ZoeGet/Omi/Tools/CodexMonitor/README.md

# Codex 状态采集实验 / Codex lifecycle monitor

Windows 主机端工具，读取 Codex Hook 的生命周期 JSON，按会话、轮次和工具调用 ID 保存状态。源码采集器只使用 Python 标准库，开发运行需 Python 3.10+；Windows 便携包已内置运行环境，终端用户无需安装 Python。

本目录负责状态来源，不实现设备传输、灯带驱动或桌面气泡；相关设备功能见根目录 README。已有快照不能当作持续在线的证明。以下带日期的实验记录保留各次验证边界，后续结果以最新现状及 Git 历史为准。

## 文件 / Files

| 文件 | 职责 |
| --- | --- |
| `collector.py` | UTF-8 输入、Windows 互斥锁、审批关联及原子快照写入 |
| `make_hooks.py` | 只向标准输出生成配置，不修改用户设置 |
| `audit.py` | 只读诊断与按会话、轮次检查 |
| `state_view.py` | CLI 只读视图及桌面实际使用的 `LifecycleReader`，不作为 Hook 入口 |
| `process_probe.py` | 只读核对 Windows 进程身份及退出信号，不推断会话状态 |
| `host_observer.py` | 从 Hook 进程的父进程链采集独立宿主证据 |
| `host_sample_collector.py` | 临时采样包装器，先执行原生命周期采集再隔离记录证据 |
| `host_bindings.py` | 按同会话/轮次/调用的 Pre/Post 配对生成候选绑定 |
| `bound_collector.py`、`host_binding_sidecar.py` | 共享事件关联与原子发布；桌面 `hook_runner.py` 通过 `run` 复用，关联失败不阻断生命周期采集 |
| `tests/test_approvals.py` | 隔离目录内的生命周期、隐私及多进程回归 |
| `tests/test_input_requests.py`、`test_lifecycle_reader.py` | 同步/异步输入、同聊天运行与跨聊天优先级、桌面生命周期延续及失效 |
| `tests/test_audit.py` | 缺失来源、目标隔离、损坏行及审批覆盖率测试 |
| `tests/test_state_view.py` | 静默、过期、损坏、时钟异常及只读性测试 |
| `tests/test_process_probe.py` | 进程身份、PID 重用、访问失败及真实隔离子进程测试 |
| `tests/test_host_observer.py` | 父进程链、采样隐私、失败隔离及绑定冲突测试 |
| `tests/test_host_binding_sidecar.py`、`test_bound_collector.py` | 事件精确匹配、迟到事件、宿主变更及真实父进程/原采集器回归 |

## 安装 / Setup

普通 Windows 用户使用完整 Omi 发布包中的首次监控向导，见 [快速开始](../Desktop/QUICK_START.md)。下面的 Python 手动安装流程保留供开发者调试和历史部署维护。桌面包使用内置运行环境执行同一生命周期/绑定逻辑，安装后的就绪检测必须等待真实新事件；不会自动授予 Hook 信任。

1. 备份已有 `~/.codex/hooks.json`，以及已有的 `~/.codex/hooks/omipet-monitor/collector.py`。保留旧状态目录作为回退证据。
2. 将本目录的 `collector.py` 复制到 `~/.codex/hooks/omipet-monitor/collector.py`。
3. 在仓库根目录运行以下命令，生成与当前解释器、安装路径对应的配置预览：

```powershell
$monitorCollectorPath = Join-Path $env:USERPROFILE '.codex/hooks/omipet-monitor/collector.py'
python Tools/CodexMonitor/make_hooks.py --collector $monitorCollectorPath
```

生成的配置包含 8 个事件。将这些处理器合并到用户级 `hooks.json`；已安装本工具时更新对应处理器，避免重复注册。保留其他工具的 Hook，不覆盖整份现有配置。处理器使用绝对解释器和脚本路径；更换 Python 或移动脚本后需要重新生成。

4. 在 Codex 中审查并信任新定义。官方 CLI 入口为 `/hooks`；安装配置不代表已经受信任。不自动修改信任记录或使用信任绕过参数。
5. 在正常聊天中验证新事件。审批只观察用户自行处理的请求，不自动批准、拒绝或制造危险操作。

上述手动步骤仅安装基础采集器，不自动建立桌面监控所需的 schema 2 宿主关联。普通用户应使用完整向导安装；开发者手动包装需同时配置下文事件关联侧文件，不能把单独的 `collector.py` 快照当作桌面就绪。

默认 `SessionStart`、`Stop`、`SessionEnd` 同步执行，其他事件异步执行；超时为 3 秒。异步事件可能乱序，不能将接收顺序当成操作发生顺序。另见 [官方 Hooks 文档](https://learn.chatgpt.com/docs/hooks)。

## 本地数据与隐私 / Local data and privacy

默认目录：`%LOCALAPPDATA%/OmiPet/codex-monitor-probe-v2`。可用进程环境变量 `OMIPET_CODEX_MONITOR_DIR` 改到隔离目录，测试使用此方法，不写真实状态。

- `events.jsonl`：收到的生命周期元数据及处理结果。
- `sessions/*.json`：各会话的轮次和工具关联状态。
- `snapshot.json`：已观测会话的汇总。
- `collector-error-<PID>.json`：失败时间和异常类型，不写原始输入或异常中的敏感内容。

只保存会话/轮次/工具 ID、事件、工作目录、权限模式和派生状态。不保存提示词、工具入参、回复、凭证或命令指纹。工作目录和 ID 本身仍是本地元数据，不应将这些日志、快照、配置备份或个人安装收据提交到 Git。

采集器退出时不向标准输出返回决策；采集失败也不会代替用户审批。

## 状态与边界 / States and limits

| 状态 | 含义 |
| --- | --- |
| `working` | 当前用户任务正在执行，且没有优先显示的同步输入或真实审批 |
| `waitingApproval` | 存在真实审批/同步输入，或当前任务已停止而仍有本任务的异步待回复问题 |
| `idle` | 当前用户任务结束/中断，且没有仍参与显示判定的运行或等待项 |
| `offline` | 收到 `SessionEnd` |
| `unknown` | 来源不足、关联不明或缺失必要标识 |

`PermissionRequest` 提供调用 ID 时，只允许同一轮次、同一调用的 `PostToolUse` 清除对应项。普通工具的开始、其他工具的完成、旧轮次的结束均不会清除它。

本机实测发现，`request_permissions` 工具的窗口可以进入 Desktop 的 `waitingOnApproval`，却不触发 `PermissionRequest` Hook。因此还将这个工具的 `PreToolUse` 作为审批开始，通过相同调用 ID 的 `PostToolUse` 解除。

通用 `PermissionRequest` 不保证提供调用 ID。缺失时，后续工具活动不能证明是哪一项审批结束，状态会降级为 `unknown`/`approvalUnconfirmed`，直到本轮结束。`PostToolUse` 只证明调用已返回，不能单独推断用户批准还是拒绝。

按轮次保留已结束记录，可阻止迟到事件复活旧任务。`foregroundTurnId` 跟踪当前用户提交的任务；新提交接替旧任务，迟到的旧工具事件/Stop 不会抢回前台。旧未结束轮次不再永久占用运行状态，背景异步问题保留 pending 记录但不阻止新任务完成；真正未完成的权限审批、同步输入和无标识事件仍保守处理。记录尚未自动裁剪。汇总只覆盖已观测会话，不能代表 Desktop 所有聊天。原始采集器不靠定时器制造业务事件；长时间没有新事件不能证明空闲或仍在线。桌面实际通过下文 `LifecycleReader` 校验宿主存活并延续已确认生命周期，但不提供独立逐聊天存活证明。

## 只读视图与桌面生命周期 / Read-only views and desktop lifecycle

`state_view.py` 不改写日志或快照，不修改安装与信任配置。它将历史观测和候选显示状态分开：

| 输出 | 含义 |
| --- | --- |
| `lastObservedStatus` | 快照中的最后观测，过期后仍保留 |
| `observationAgeSeconds` | 当前时间与该会话观测时间之差 |
| `displayStatus` / `reason` | 候选显示状态及其依据 |
| `sourceState=readable` | 文件可读，不代表 Codex 或采集器在线 |
| `liveness=unverified` | 当前没有持续存活证据 |

CLI 默认未设置新鲜度策略，各会话显示 `unknown`，不会将历史红/黄/绿作为当前状态。调用方可显式传入正数 `--max-age-seconds`；测试中的 10 秒仅为合成边界测试。`read_bound_view` 保持该保守行为。桌面专用 `LifecycleReader` 只在近期、精确事件证明且宿主存活时接纳生命周期；后续没有新 Hook 仍保持工作/等待，独立评估传输有效期，不改写事件时间。来源不可读、身份/证明变化或宿主失效会清除接纳记录，重开监控不会接纳过期历史。它不证明具体聊天存活；当前任务漏掉 Stop 且没有新的用户任务接替时仍可能保留旧状态；新的用户任务会接替旧任务，自己的 Stop 可正常结束。

2026-10-16 一致性修复：`bound_collector.py` 在原有同目录互斥锁内完成生命周期与侧文件发布，桌面读取同样持有这把锁，避免新快照配上旧证明而短暂降级。锁的原有 1 秒等待上限不变；无法取得锁时仍显示 unknown 并清除延续资格，不沿用未核验状态。桌面后台和已安装包装器需配套更新；只升级其中一个不能保证一致性。并发回归已先复现旧实现读到半次发布，再验证新实现等待完整发布后读到结束状态；此前 30 分钟的 3 次 unknown 缺少逐次原因，不能全部归因于这一竞态。

`request_user_input` 的 Pre/Post 对应等待/回复完成；`request_user_input_async` 的 Post 只表示窗口已创建，等待需保留到 `UserPromptSubmit` 中对应 `send_user_message_question_reply` / `questionItemId` 回复，或中断/会话结束。待回复跨 Stop 保留，防止创建选项后结束本轮便错误变绿；其他工具调用与无关联文本不清除它。同一聊天继续执行时显示 working，当前任务停止且仍有本任务的异步问题时显示 waitingApproval；新用户任务接替后，旧问题只保留为背景记录，不自动标记已回答，也不覆盖新任务的完成状态；真实权限审批和同步输入仍优先显示 waitingApproval。不同聊天之间仍保持等待优先。自由输入选项使用同一回复关联，不保存问题、选项或回答文本。该应用回复格式来自本机实测，非通用 Hooks 稳定协议；格式改变需重新验证。[官方 Hooks 文档](https://learn.chatgpt.com/docs/hooks) 的工具返回事件不能等同异步人工回复。

每个会话分别计算年龄，不使用全局快照生成时间刷新其他聊天。超期、未来时间、缺少时区或非法记录均显示未知；静默不会产生 `Stop`、`idle` 或 `offline`。汇总保留等待审批、工作、未知、空闲、离线的优先级，未知会阻止仅凭另一个空闲会话显示全局空闲。

```powershell
python Tools/CodexMonitor/state_view.py
python Tools/CodexMonitor/state_view.py --source-unavailable
python Tools/CodexMonitor/tests/test_state_view.py
```

`--source-unavailable` 由调用方在已有独立失联证据时传入；该工具不探测或终止进程。来源缺失或损坏时同样返回未知，并给出来源原因；不尝试修复真实数据。

2026-10-14：状态视图 16 项、进程探针 10 项、宿主观测/绑定 16 项和审计 5 项测试通过，其中包括 Windows 隔离子进程真实退出及联动降级。开启宿主采样后的包装器还通过 52 条生命周期事件和 6 会话并发回归，最长单次约 0.281 秒。视图尚未接串口或灯带；不能宣称真实 Codex 会话异常退出已被自动识别。

## 进程证据 / Process evidence

`process_probe.py` 通过 Windows 的查询和同步权限读取进程，不读取命令行、环境变量、内存或登录资料，不终止被观察进程。身份由 PID、原始 100 ns 创建时间字符串和完整映像路径共同组成；创建时间使用字符串以免 JSON 数值精度损失。

核对使用同一个进程句柄读取创建时间与映像，并零等待检查退出信号。PID 重用、映像变化和访问失败均不能刷新原来源。进程退出或无法确认时显示未知；进程存活只表示主机进程存在，不证明聊天正在工作、Hook 正常或 UI 有响应。实现依据见 Microsoft 的 [GetProcessTimes](https://learn.microsoft.com/en-us/windows/win32/api/processthreadsapi/nf-processthreadsapi-getprocesstimes)、[QueryFullProcessImageNameW](https://learn.microsoft.com/en-us/windows/win32/api/winbase/nf-winbase-queryfullprocessimagenamew) 与 [WaitForSingleObject](https://learn.microsoft.com/en-us/windows/win32/api/synchapi/nf-synchapi-waitforsingleobject)。

入口：`process_probe.py --capture-pid <明确选择的PID>` 仅打印身份；`process_probe.py --identity <身份文件>` 重新查询该身份。生成的身份文件包含个人程序路径，不提交 Git。工具不按进程名自动选择宿主。

状态视图支持 `--process-bindings <绑定文件>`，格式如下，所有值均需由实测填写，不能照抄示例：

```json
{
  "schema": 1,
  "sessions": {
    "<已验证的session-id>": {
      "pid": 123,
      "creationTime100ns": "<capture返回的精确字符串>",
      "imagePath": "<capture返回的完整路径>"
    }
  }
}
```

每次读取视图都会重新查询对应进程，不信任旧的探针结果文件。缺失或非法绑定会降级未知；绑定进程运行也不能绕过缺省策略、观测过期或独立失联证据。这是附加的失效检查，不会把历史观测升级成实时状态，也不改写 Hook 日志。

## 真实 Hook 宿主采样 / Live Hook launcher sampling

`host_sample_collector.py` 是独立实验包装器。它优先加载同目录保存的 `lifecycle_collector.py`，仓库内运行时回退到原 `collector.py`；先完成原有采集，再读取同目录的 `host-observer.json`。未放置配置时不采样；采样配置/查询失败也不改变生命周期结果或标准输出。配置需明确给出 `enabled`、程序完整路径列表 `allowedImages` 和独立的绝对 `outputDirectory`。

父进程链通过只读 Windows Toolhelp 快照获得，再逐个核对创建时间、完整映像路径和存活状态。父进程比子进程新、链循环或查询期间身份变化时拒绝关联；只接受路径列表中最近的祖先进程。这里只证明 Hook 的启动来源，不代表进程独占会话或会话仍在运行。实现依据见 [PROCESSENTRY32W](https://learn.microsoft.com/en-us/windows/win32/api/tlhelp32/ns-tlhelp32-processentry32w) 和 [CreateToolhelp32Snapshot](https://learn.microsoft.com/en-us/windows/win32/api/tlhelp32/nf-tlhelp32-createtoolhelp32snapshot)。

每条样本使用独立随机文件名，只保存会话/轮次/调用 ID、事件、时间与祖先进程的 PID/创建时间/路径。样本可能包含个人目录，须保存在本地，不提交 Git。旧 `events.jsonl` 和快照格式不增加字段。

2026-10-14 19:27–19:28 的短暂真实采样得到 2 个会话、9 条 Pre/Post 事件；9 条均为 `Python → PowerShell → 同一个 codex.exe`。原采集器随后按 SHA-256 恢复，Hook 定义及信任记录未改，未安装持续后台任务。不同会话共享同一宿主，不能将进程当作聊天的独立心跳。第二个同名进程未因名称相同而被绑定。

`host_bindings.py --observations <样本目录>` 只向标准输出生成候选。每个会话须有同轮次、同调用 ID 的 Pre/Post 配对，且该批样本中的宿主身份一致；重复开始、其他调用/轮次的完成、未知或冲突宿主均不能满足绑定。损坏的输入使整个输入失效。输出保留配对证据数，`sessionLiveness` 始终未验证。

该批真实样本生成 2 个候选绑定，分别含 1 和 2 组工具配对。只读接入状态视图时两个宿主查询均为 running；没有观测有效期策略，汇总仍是 unknown。候选未启用持续采样，绑定只覆盖已观测的启动来源，不能外推到所有历史聊天或重启后的新来源。

## 持续事件绑定 / Event-correlated bindings

当前桌面安装使用版本化目录中的 `omi-device.exe --collect-hook`，由 `hook_runner.py` 调用 `bound_collector.run`；配置允许的 Codex 程序路径，设备当前视图上限仍为 16 个会话。磁盘上的历史状态和宿主证明不占这个名额；旧配置中的正数 `maxSessions` 保留兼容校验，不再限制历史证明写入，实际设备上限由桌面协议协商执行。新版本安装会备份并更新自有 Hook 定义，信任由 Codex 用户完成。侧文件位于状态目录的 `host-bindings.json`，包装器在原有互斥锁内发布生命周期和证明；关联失败不阻断原采集结果。开发者的手动脚本部署仍可使用同目录 `lifecycle_collector.py` 和 `host-binding-config.json`，不要与桌面安装重复注册。

同一会话、轮次及工具调用的 `PreToolUse`/`PostToolUse` 必须来自同一个经查询的父进程身份，才会标记 confirmed；之后每次事件还需与刚写入的原始时间、事件、轮次、调用 ID 以及 `applied=true` 精确对应。身份变化须重新配对，`SessionEnd` 删除该绑定。视图每次读取重新检查进程身份与最新事件证明；未覆盖的历史会话、迟到事件、损坏证据和过期事件均显示 unknown。进程存在仍不证明聊天持续运行。

历史验证（2026-10-15）：52 条合成事件与 Windows 父进程回归通过，随后真实 Hook 形成 confirmed 绑定并用于 USB 只读复测。持续关联只能随新事件覆盖当前会话，不能补造历史聊天。当前升级/卸载使用桌面向导的安装记录和备份；不要用早期本机临时探针脚本覆盖新版入口。恢复后旧侧文件证明也不能直接当成新事件。

USB/Wi-Fi 共用消息协议及真实观测桥接见 [DeviceBridge](../DeviceBridge/README.md)。USB 实验固件于 2026-10-14 完成首次烧录验证；`bridge.py` 可在前台持续读取本工具的原有快照，将临时别名和最后观测状态发送到设备，停止时尝试释放。2026-10-15 验证采用周期 1 秒、超时 2 秒、重试 1 次并运行 60 秒；未设置业务有效期，设备显示强制 unknown。SDK SOF 计数缺陷已通过隔离副本修复并烧录；复测 60 秒获 56 个真实观测 ACK，零超时/重建，link_losses 首尾均为 2、未新增，确认退出释放。长期稳定仍待验证。没有修改 Hook 或安装后台服务；该轮未验证真实控灯、新鲜度挑战和 Wi-Fi 传输；这些现已由 DeviceBridge 与桌面集成，当前边界见对应文档。

## 复核 / Verification

在仓库根目录运行：

```powershell
python Tools/CodexMonitor/tests/test_approvals.py
python Tools/CodexMonitor/tests/test_audit.py
python -m unittest discover -s Tools/CodexMonitor/tests -p test_input_requests.py
python -m unittest discover -s Tools/CodexMonitor/tests -p test_lifecycle_reader.py
python Tools/CodexMonitor/audit.py
python Tools/CodexMonitor/audit.py --session <session-id> --turn <turn-id>
```

生命周期测试包含 52 条合成事件和 6 会话并发；测试报告写在输出注明的临时目录，不写源码目录。审计工具支持 `--root` 指定其他来源、`--output` 导出报告。按目标轮次检查 `turnStatus`，不要用另一个聊天的 `Stop` 或当前会话的新消息替代完成证据。

2026-10-14 的实测边界：中文回复结束可正确记录 `Stop`；一个修复后的 `request_permissions` 窗口在用户批准后完成 `waitingApproval → working → idle`，同一调用的待审批数从 1 变为 0。期间其他聊天活动未覆盖等待状态。此为有限样本，拒绝、所有审批来源、长期稳定性和失联处理未全部验证。

## Codex 更新后排查与本次修复 / Upgrade troubleshooting

2026-10-19 修复了两个独立问题，之后复现时应分开诊断：

- **来源异常**：本机 Codex 更新后，原先选定的带版本目录的 `codex.exe` 路径失效，采集器的 `allowedImages` 仍指向旧路径。重新选择当前实际运行的 Codex 程序、修复安装、信任新 Hook，再取得真实同调用 Pre/Post 配对后恢复 `ready`。这是本次路径变化的原因，不能把所有来源异常都归因于更新。
- **结束后一直红**：真实 `Stop` 已收到，目标轮次 `turnStatus=idle`，会话汇总却仍 `status=working`；历史漏结束事件的轮次一直参与汇总。修复在 `collector.py` 保存 `foregroundTurnId`，由新用户任务接替旧普通工作；迟到的旧工具/Stop 不夺回前台。背景异步问题保留 pending，不伪造回答，也不阻止新任务完成；本任务待回复问题、真实审批与同步阻塞仍按前文规则处理。旧状态缺少此字段时从原 `turnId` 迁移。

### 恢复顺序

1. 保留日志及安装记录。在 Omi 设置的监控入口重新检测，核对当前实际运行的 Codex 程序；不要固定某个版本目录，也不要仅因同名进程就放宽路径校验。
2. 若路径变化，断开设备，重新选择当前 Codex 程序，点击“修复 / 更新监控”。若同时升级了采集逻辑，先更新完整 Omi 发布包，再通过此入口更新已安装组件：只换仓库源码、ZIP 或 Omi.exe 不会替换独立安装的旧采集器。覆盖发布目录前从托盘真正退出 Omi。
3. 安装器备份并合并自有 Hook，保留其他工具配置。在 Codex 审查并信任新定义；若新定义尚未加载，重新加载配置或重启 Codex 后再审查。不要自动修改信任记录，不要把重复点击安装当成收到事件的替代品。
4. 让 Codex 执行普通工具操作，再重新检测。确认 `hook-receipt.json` 的 `installationId` 与当前安装收据一致，宿主同一会话/轮次/调用的 Pre/Post 关联确认，设置显示 `ready`。单有采集事件或进程存在不够。
5. 开启设备监控，执行约 30 秒操作，结束后观察；再发送一个异步选项，暂不回答，观察黄灯，回答后观察恢复。默认颜色应为运行红、结束绿、待回复黄；自定义灯效按对应状态验收。真实权限审批另测，不为测试制造危险操作。

### 需要保留的证据

- `%LOCALAPPDATA%/OmiPet/monitor-setup.json`：当前安装 ID、所选 Codex 路径、运行目录及文件哈希；`monitor-backups/` 保存安装前配置。
- 状态目录中的 `hook-receipt.json`、`host-bindings.json`、`events.jsonl`、`sessions/*.json`：核对实际执行的版本、宿主关联和目标轮次事件。`CODEX_HOME` 或状态目录被显式改动时以实际配置为准。
- 结束仍红时，先区分“未收到目标 Stop”和“收到 Stop 但汇总错误”；对比 `turnStatus`、会话 `status`、`foregroundTurnId`、各轮次等待项。全会话 `pendingInputCount` 可含背景问题，非零不一定应亮黄灯。沿用上文 `audit.py --session ... --turn ...`，不要用其他轮次的 Stop 代替证据。
- 以上安装记录和日志含个人路径/标识，仅本地保留；不要提交 Git。不要删除快照、伪造 Stop 或放宽宿主校验来让灯变绿。

### 前台任务修复验证与边界

80 项监控单元测试、13 项输入/前台轮次专项测试、原有 9 组审批回归（52 合成事件/6 并发会话）、冻结采集器验证及 Windows 打包通过。2026-10-19 用户保持设备监控连接：30 秒真实操作期间为 `working`，用户确认结束恢复绿；异步选项未回答时确认黄，回答后再次确认正常。对应真实日志记录 `Stop → idle`、选项待回复 `Stop → waitingApproval`、回答后的 `Stop → idle`。本轮未重新实测真实权限审批、断线与长期运行；当前任务漏 Stop 且无新任务接替仍无法独立证明完成。Codex 若改变事件字段、异步回复格式或宿主结构，需要重新验证并按证据修复，不保证升级后永不适配。

原始事件、安装收据和备份仅在本地保留，以上内容为脱敏验证摘要。

### 历史聊天超过设备容量导致来源异常

2026-10-19 随后复现了另一个原因：历史快照累计 17 个聊天，而侧文件写入曾以整个历史快照长度检查 16 会话容量，导致所有当前宿主证明停止更新；设备映射也拒绝 17 条历史记录。此时安装版本和 Codex 路径均正确，重复修复安装无法消除根因。

修复将历史与当前视图分开：侧文件继续保存各聊天的真实证明；`LifecycleReader` 不把启动前已过原有 30 秒预算且未接纳的旧记录送往设备，已确认结束的聊天只保留最新一个作为空闲/离线显示。已接纳的运行/等待仍跨静默保留；本轮曾观察的未结束聊天即使证明失效，也继续显示未知，不因归档让另一个空闲聊天误报绿色。新事件可以重新激活历史聊天。原始日志、会话文件及完整快照不删除、不改写。只读审计接口仍展示全部历史，桌面视图用 `historicalSessionCount` 说明未参与当前显示的数量。

真实同时参与显示的会话仍受设备 16 会话上限约束，超限继续报告异常，不截断活动审批；设备临时别名累计耗尽仍按既有流程重新握手。回归覆盖 17 条历史、18 条宿主证明、长任务/等待、完成记录收拢、证明丢失与真实活动超限。本次修复必须同时更新 Omi 后台与已安装采集器，再信任新定义并验证真实事件；仅重装旧包无效。实机验收范围见本节末尾的验证摘要。

累计聊天和磁盘历史没有固定数量上限，也没有自动裁剪策略，实际仍受存储、内存和处理时间限制。16 是当前设备视图的协商上限，包含参与显示的未知条目和保留的最新结束记录，不能理解成“只能累计新建 16 个聊天”或“只计算正在运行的聊天”。历史增多不再触发旧的全局停写条件；当前视图确实超限仍失败关闭。“电脑仅发最终汇总状态”的方案尚未实现。

本次容量修复最终通过 83 项监控单元测试、32 项设备协议及 29 项桥接回归，冻结包的关联/状态/传输验证通过。新版后台和采集器已安装并由用户信任；真实现场保留 17 个历史聊天，30 秒 7 次检查均为 `working`，当前传输 1 个会话，16 条历史记录不占当前名额，用户随后确认灯色已恢复。本轮未重新实测真实权限审批、断线或长期稳定性，不能据短测承诺无限会话或长期无故障。

## 回退 / Rollback

恢复安装前保存的脚本和对应的 Hook 定义，核对之后是否追加了其他配置；定义变化后按 Codex 提示重新审查。保留原日志与快照，不把新旧采集器同时写到同一状态目录。停用时只禁用本工具对应的处理器。

2026-10-15 状态有效期候选已在 USB 桥接层加入显式参数和传输时间预留；默认仍显示 unknown。以前短时采样生成的 2 个宿主绑定本次复核均为 unknown，因此不能用于开启真实状态。在显式 30 秒实验预算下，短时采样取得 1 个当前会话绑定并恢复原采集器；仅显式实验启用，未接灯带，详见 DeviceBridge 文档。

2026-10-15 后续将 Hook 采集时间同时绑定到 Windows 单调时钟计数，侧文件增加十进制 `observedMonotonicNs`。schema 2 视图用它计算事件年龄；缺失、倒退或异常计数一律 unknown。桥接生成快照时再扣除单调时钟经过的时间，墙上时间跳变不能延长已观测状态。原 UTC 时间仍用于审计；宿主进程身份实时核对也阻止重启后的旧计数直接沿用。旧侧文件记录会因缺少单调证明降级，直到新 Hook 事件更新。当次用户级包装器按哈希升级，未更改当次 Hook 定义和原生命周期采集器；当前便携包升级使用版本化安装，定义变化需重新审查。
