ZoeGet/Omi/Hardware/Enclosure/Backcover.STEP

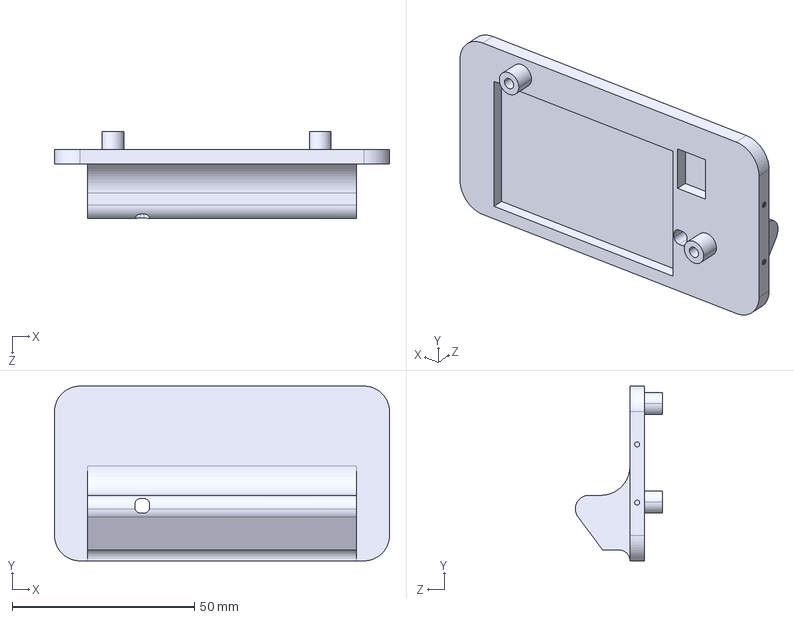
[picture p1: CAD file, 2026-10-14]
Hardware/Enclosure/Backcover.STEP
92.0 x 48.0 x 24.0 mm
