ZoeGet/Omi/Hardware/Enclosure/Frontcover.STEP

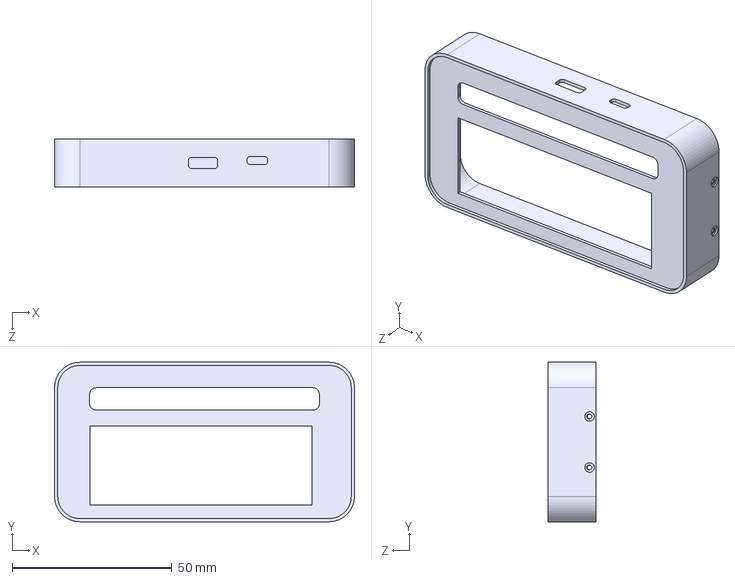
[picture p2: CAD file, 2026-10-14]
Hardware/Enclosure/Frontcover.STEP
94.0 x 50.0 x 15.0 mm
