ZoeGet/Omi/Firmware/include/omi_ui_font.h

#pragma once
#include <cstdint>

//  生成的 Omi UI 字模，源字体及许可见 assets/fonts / Generated Omi UI glyphs; source and license in assets/fonts
//  使用 generate_ui_font.py 重建，4 位覆盖率按行高半字节优先 / Rebuild with generate_ui_font.py; row-major 4-bit coverage, high nibble first
namespace OmiPetUiFont {
struct Glyph { uint32_t codepoint, offset; uint8_t size, width, height, advance; int8_t left, top; };
constexpr uint8_t kPixels[] = {
  0x04, 0x10, 0x0b, 0x40, 0x0a, 0x30, 0x0a, 0x30, 0x0a, 0x20, 0x09, 0x20, 0x04, 0x10, 0x05, 0x20, 0x0c, 0x50, 0x02, 0x02, 0x00, 0xf0, 0xd3, 0x0e,
  0x0c, 0x20, 0xb0, 0xa0, 0x00, 0x00, 0x00, 0x00, 0x00, 0x00, 0x00, 0x00, 0x00, 0x00, 0x00, 0x00, 0x00, 0x00, 0x90, 0x90, 0x02, 0x80, 0xa0, 0x3b,
  0xda, 0xd8, 0x05, 0x51, 0x90, 0x07, 0x32, 0x70, 0x6d, 0xbc, 0xc5, 0x0a, 0x06, 0x40, 0x0a, 0x08, 0x20, 0x00, 0x00, 0x00, 0x00, 0x47, 0x00, 0x02,
  0xbe, 0x90, 0x0c, 0x51, 0x70, 0x0e, 0x10, 0x00, 0x06, 0xd5, 0x00, 0x00, 0x2b, 0xa0, 0x00, 0x00, 0xc4, 0x15, 0x00, 0xd3, 0x19, 0xdd, 0x70, 0x00,
  0x47, 0x00, 0x00, 0x00, 0x00, 0x1b, 0xb6, 0x00, 0x55, 0x00, 0x56, 0x0b, 0x00, 0xa0, 0x00, 0x84, 0x0b, 0x17, 0x30, 0x00, 0x66, 0x0c, 0x19, 0x4b,
  0xa1, 0x1a, 0xa5, 0x82, 0xb1, 0x48, 0x00, 0x02, 0x80, 0xb0, 0x2a, 0x00, 0x09, 0x10, 0xa0, 0x48, 0x00, 0x46, 0x00, 0x4b, 0xb2, 0x01, 0xbb, 0x50,
  0x00, 0x07, 0x70, 0xc0, 0x00, 0x06, 0x87, 0x80, 0x00, 0x03, 0xf8, 0x00, 0x41, 0x2c, 0x9b, 0x02, 0xd0, 0x77, 0x08, 0xaa, 0x60, 0x7b, 0x00, 0xce,
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
  {65, 725, 11, 7, 8, 7, 0, -8},
  {66, 753, 11, 7, 8, 7, 0, -8},
  {67, 781, 11, 7, 8, 7, 0, -8},
  {68, 809, 11, 8, 8, 8, 0, -8},
  {69, 841, 11, 6, 8, 6, 0, -8},
  {70, 865, 11, 6, 8, 6, 0, -8},
  {71, 889, 11, 8, 8, 8, 0, -8},
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
};
}  //  字模命名空间 / Glyph namespace
