ZoeGet/Omi/(commit log)

2026-10-12 fix(led): prevent color corruption when switching brightness
    [led_controller.cpp, led_controller.h, main.cpp]
2026-10-12 Show battery percentage only on display
2026-10-14 Update front and back enclosure STEP models
    [Backcover.STEP, Frontcover.STEP]
2026-10-14 chore(enclosure): update back cover STEP model
    [Backcover.STEP]
2026-10-14 feat(monitor): add Codex lifecycle and approval collector
    Track per-session turns and correlate permission tools by call ID. Preserve uncertain approval states, ignore late events, and keep raw inputs out of local metadata.
    Include a read-only hook configuration generator and 52-event regression coverage with six concurrent sessions.
2026-10-14 docs(monitor): document setup and validated lifecycle behavior
    Describe hook installation, local metadata privacy, approval correlation, regression commands, and rollback. Record the limits of the observed approval sample and the remaining source-liveness work.
2026-10-15 chore(repo): define publication boundaries and staged checks
2026-10-15 feat(desktop): add Windows USB device control center
2026-10-15 fix(desktop): fit light summaries and stack mode switches
2026-10-16 docs(desktop): record current user feedback and handoff status
2026-10-16 perf(desktop): bound retained USB diagnostic traces
2026-10-16 feat(desktop): add stdio adapter for shared device control
2026-10-16 feat(desktop): replace Tk interface with Tauri control center
    [collect_licenses.py, main.rs, verify_usb.py]
2026-10-16 fix(monitor): preserve admitted task state during quiet periods
    [controller.py, protocol.py]
2026-10-16 fix(firmware): filter transient USB link signals in isolated builds
    [device_protocol_experiment.cpp, device_protocol_transport.h, protocol_experiment_config.h, transport_native.cpp]
2026-10-16 fix(bridge): release lost preconnected monitor sessions
    [bridge.py]
2026-10-16 docs(usb): record link-filter validation and remaining state gaps
2026-10-16 docs(monitor): document snapshot consistency and device validation
2026-10-16 feat(firmware): add isolated authenticated wireless pairing
2026-10-16 feat(bridge): persist and verify paired WSS device identities
2026-10-16 feat(desktop): add background wireless pairing and reconnect verification
2026-10-16 docs(pairing): record device validation and remaining wireless scope
2026-10-16 feat(firmware): route authenticated wireless control with USB priority
2026-10-16 feat(desktop): connect paired devices to shared wireless controls
2026-10-16 docs(wireless): record control behavior and device validation
2026-10-16 fix(audio): retain queued frames beyond the per-loop budget
    [audio_budget_native.cpp, main.cpp]
2026-10-16 refactor(wireless): share bounded text frame reception
2026-10-17 feat(firmware): persist per-state monitor light profiles
    Store all five monitor light profiles in a versioned NVS record shared by
    USB and WSS sessions. Read back the saved configuration in acknowledgements
    and reject stale revisions without overwriting another connection's changes.
    Apply the selected profile while preserving voice priority, disconnect-off
    behavior, and the local light brightness when monitoring ends.
    Validate atomic saves, reboot loading, retries, storage failures and
    cross-transport conflicts with native sanitizer checks. Default and isolated
    firmware builds pass; physical reboot validation remains pending.
    [device_protocol_envelope.cpp, device_protocol_envelope.h, device_protocol_experiment.cpp, device_protocol_session.cpp, device_protocol_session.h, device_protocol_transport.h, main.cpp, monitor_light_profiles.cpp]
2026-10-17 feat(bridge): support monitor light profile requests
    Validate complete five-state profiles and retain the device-confirmed
    configuration from negotiated acknowledgements. Model profile reads, writes,
    revision conflicts and save failures in the shared device simulator.
    Keep profile support optional for compatibility with existing firmware.
    [protocol.py, simulator.py]
2026-10-17 feat(desktop): add persistent monitor light settings
    Add a monitor-light page for editing each state's color, brightness and
    effect. Read the device configuration, save all states together and show
    success only after the device confirms the operation.
    Preserve unsaved edits after failures, require a refresh after revision
    conflicts and disable the controls on firmware without profile support.
    Use saved profiles in the overview and light rules.
    Cover the shared backend flow, validation, retries and editor interactions.
    Physical persistence and native visual acceptance remain pending.
    [backend.py, controller.py, worker.py]
2026-10-18 feat(desktop): rebuild Omi interface with Fluent UI
    Use modular pages and system light and dark themes. Add resizable navigation, Omi branding, and the Mikoto application icon while preserving device confirmation and monitor configuration guards.
2026-10-18 build(desktop): package portable app as Omi.exe
    Replace the legacy executable entry and include the app icon source notice. Document the Fluent UI modules, system themes, resizable sidebar, and current portable launch path.
2026-10-18 docs(protocol): align pairing and monitor guidance with current firmware
2026-10-19 fix(wifi): persist and retry five saved networks
    [wifi_manager.cpp, wifi_manager.h]
2026-10-19 docs(project): document monitor recovery and current behavior
2026-10-19 fix(monitor): separate historical sessions from device capacity
2026-10-19 docs(project): clarify monitor capacity and refresh validation status
2026-10-19 fix(led): default local startup effect to rainbow
    [main.cpp]
2026-10-19 refactor(desktop): simplify wireless pairing and recovery controls
2026-10-19 fix(desktop): keep wireless connection guidance compact
2026-10-20 feat(desktop): reconnect devices and track light application
2026-10-22 build(firmware): pin validated platform and document setup
2026-10-22 fix(firmware): recover sensor initialization and consolidate update paths
    Add default-off staged AHT20 sampling with driver regression tests. Preserve sensor compensation, Wi-Fi portal triggers and LED behavior while sharing duplicate update code.
    [aht20_sensor.cpp, aht20_sensor.h, led_controller.cpp, main.cpp, wifi_manager.cpp, wifi_manager.h]
