ZoeGet/Omi/(notices)

Notices in the files:
README.md:
软件许可 GPL-2.0
